Beringusz/Thrust_Vector_System/Thrust Vector Model/images/tvc_photo2.jpg

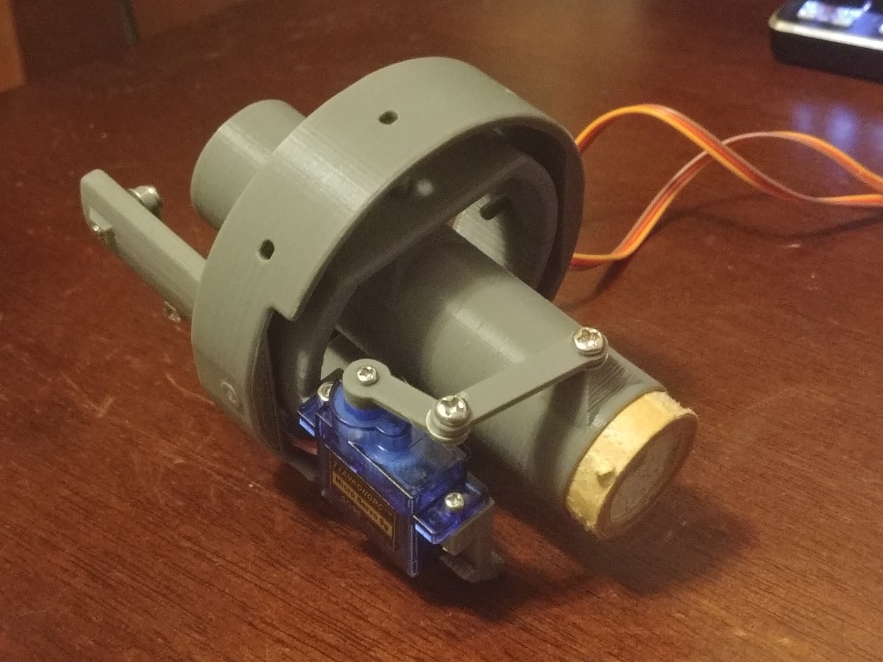
Thrust Vector Model/images/tvc_photo2.jpg
