Beringusz/Thrust_Vector_System/Thrust Vector Model/images/tvc_1.PNG

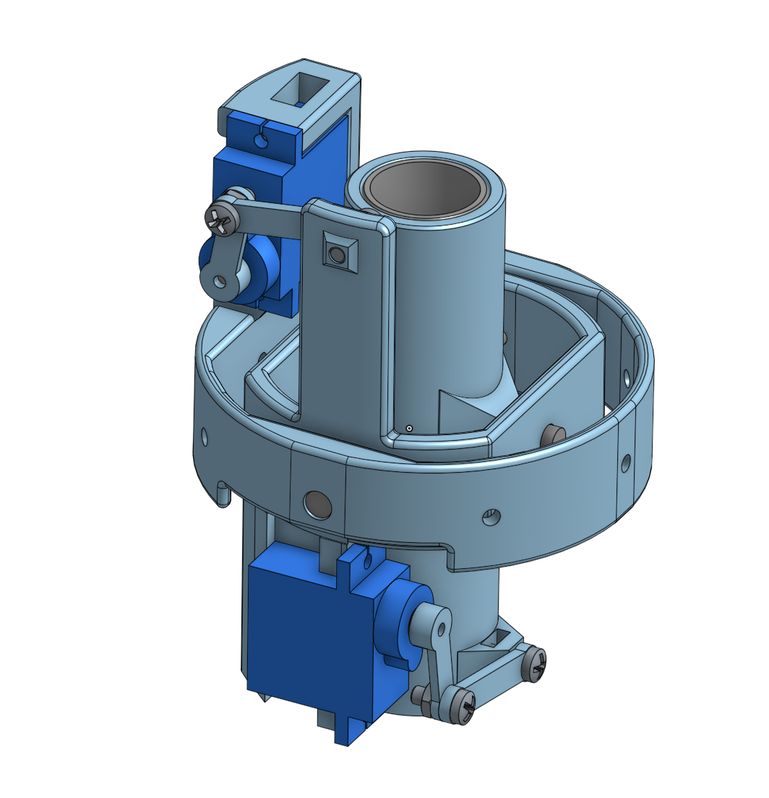
Thrust Vector Model/images/tvc_1.PNG
