Beringusz/Thrust_Vector_System/Thrust Vector Model/images/tvc_2.PNG

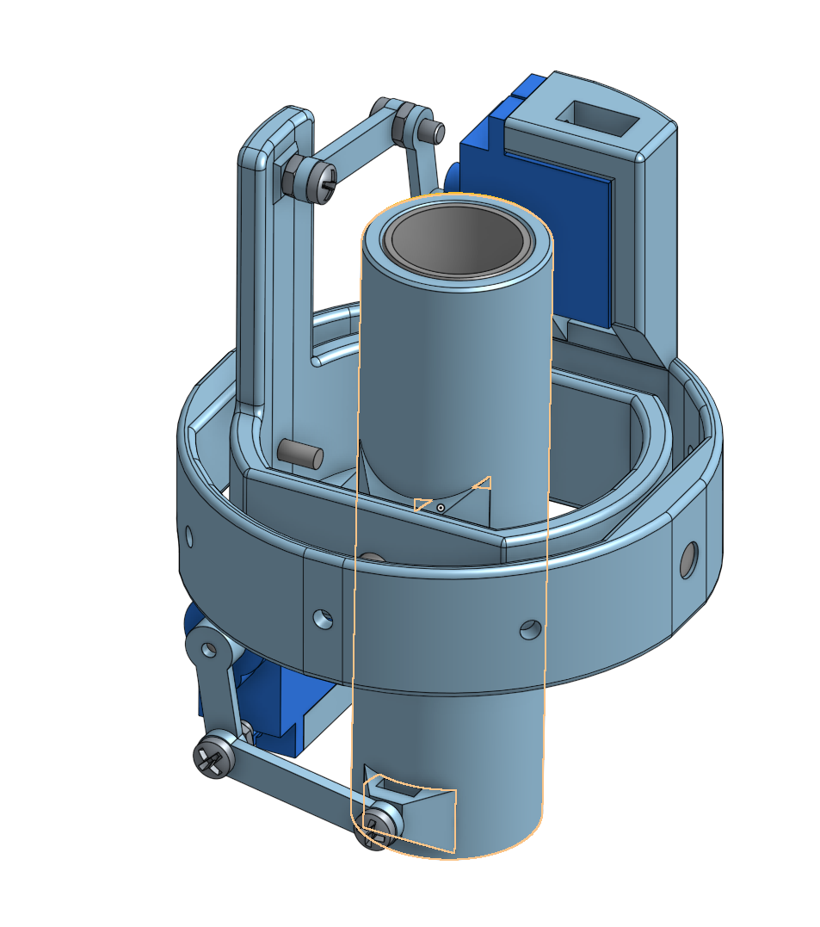
Thrust Vector Model/images/tvc_2.PNG
