Beringusz/Thrust_Vector_System/Thrust Vector Model/images/tvc_3.PNG

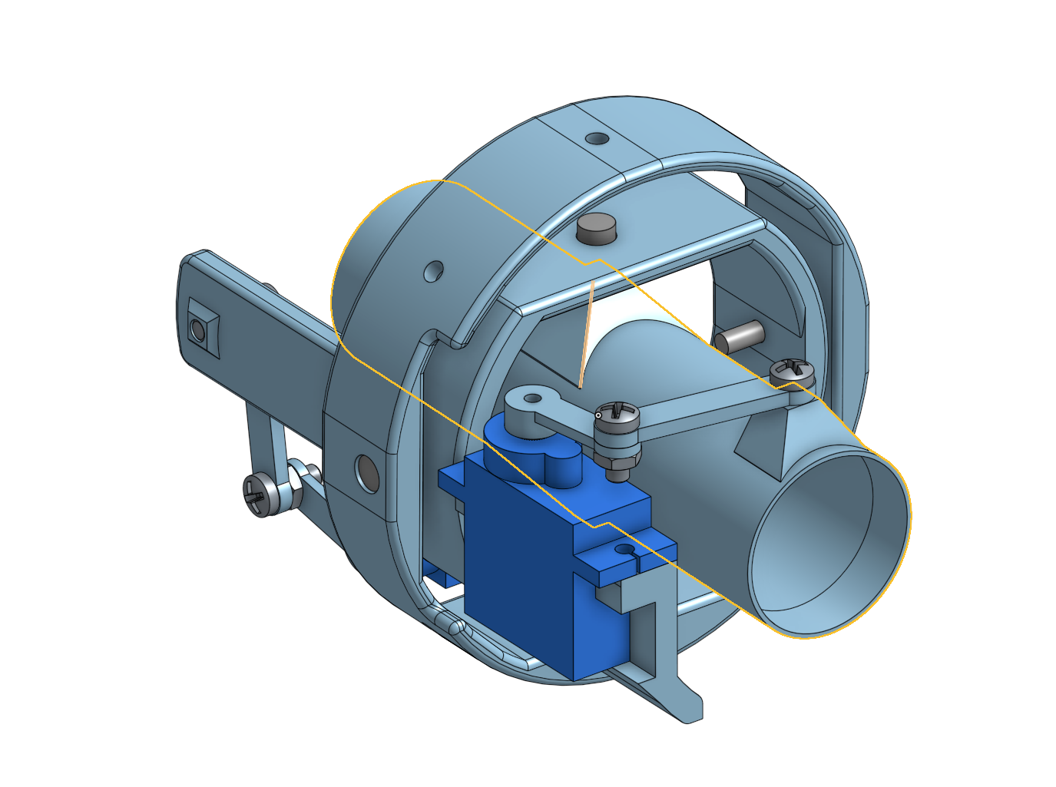
Thrust Vector Model/images/tvc_3.PNG
