Beringusz/Thrust_Vector_System/Thrust Vector Model/files/95mm_Buffer.stl

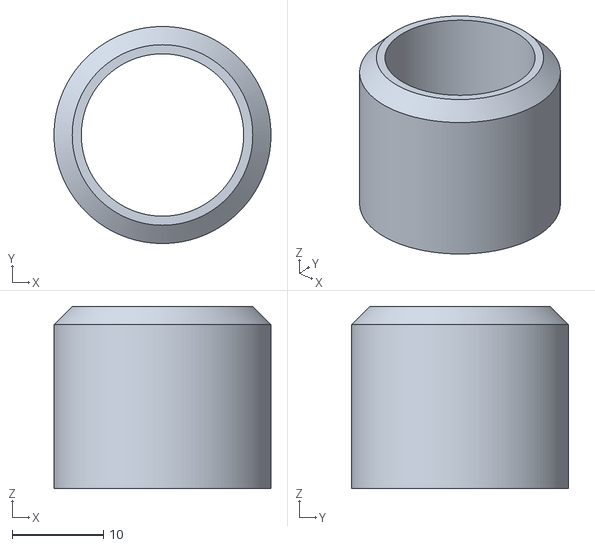
[picture p14: CAD file, 2026-10-13]
Thrust Vector Model/files/95mm_Buffer.stl
23.8 x 23.8 x 20.0
