Beringusz/Thrust_Vector_System/Thrust Vector Model/files/ServoHorn_15mm.stl

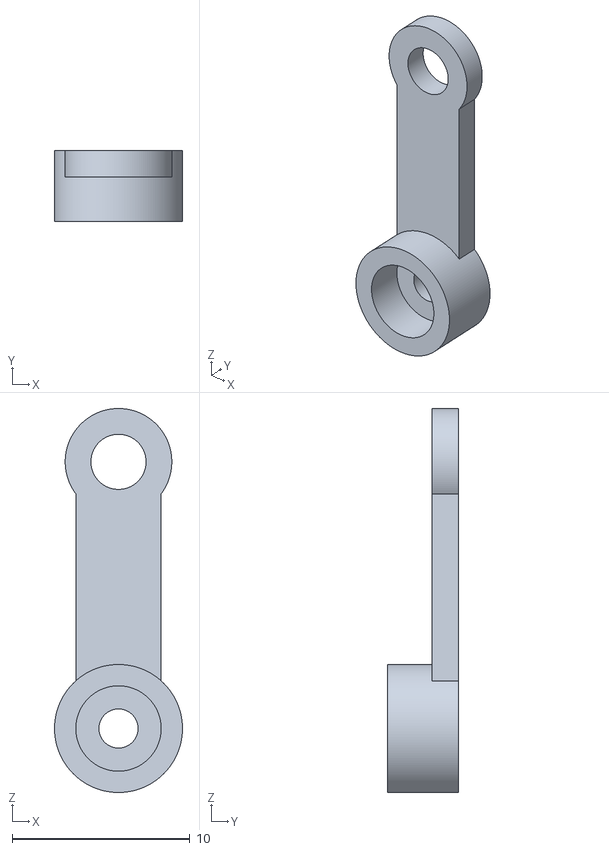
[picture p15: CAD file, 2026-10-13]
Thrust Vector Model/files/ServoHorn_15mm.stl
7.20 x 4.00 x 21.6
