Beringusz/Thrust_Vector_System/Thrust Vector Model/files/MotorShroud_24x75.stl

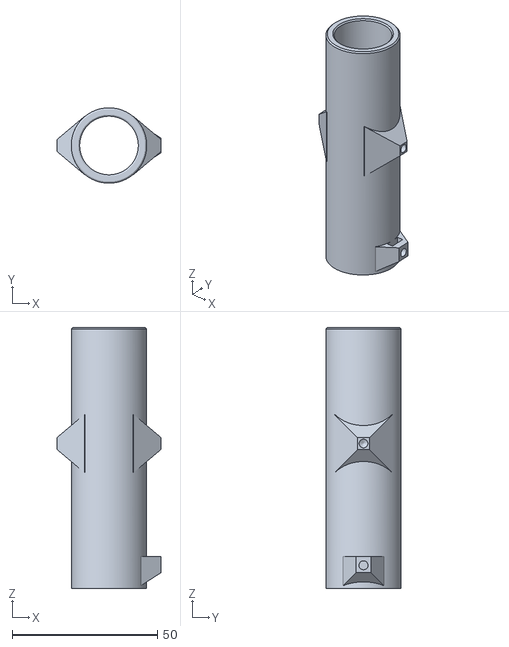
[picture p16: CAD file, 2026-10-13]
Thrust Vector Model/files/MotorShroud_24x75.stl
36.0 x 26.0 x 90.0
