Beringusz/Thrust_Vector_System/Thrust Vector Model/files/YAxisPin.stl

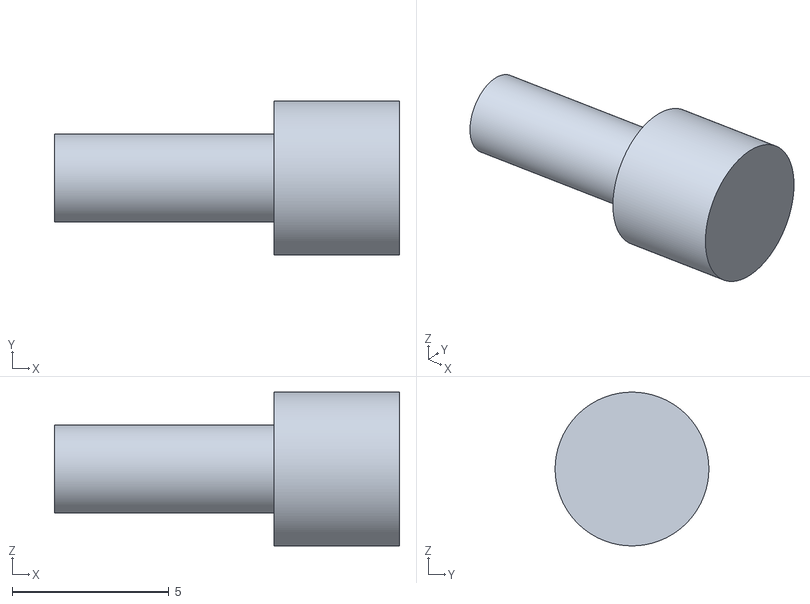
[picture p17: CAD file, 2026-10-13]
Thrust Vector Model/files/YAxisPin.stl
11.0 x 4.90 x 4.90
