Beringusz/Thrust_Vector_System/Thrust Vector Model/files/XAxisPin.stl

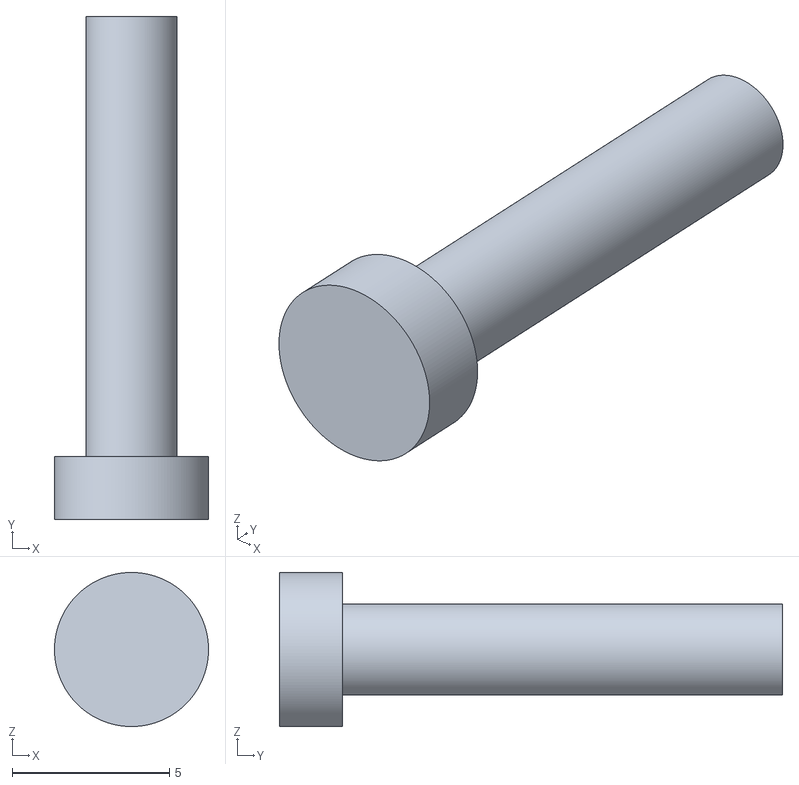
[picture p18: CAD file, 2026-10-13]
Thrust Vector Model/files/XAxisPin.stl
4.90 x 16.0 x 4.90
