Beringusz/Thrust_Vector_System/Thrust Vector Model/files/OuterGimbal.stl

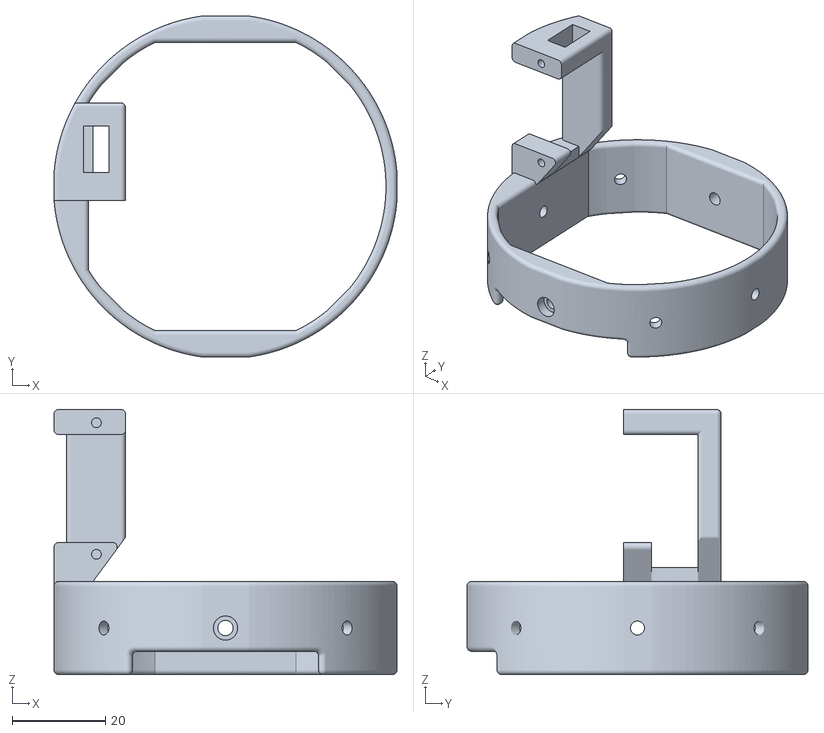
[picture p19: CAD file, 2026-10-13]
Thrust Vector Model/files/OuterGimbal.stl
73.8 x 73.3 x 57.0
