Beringusz/Thrust_Vector_System/Thrust Vector Model/files/ConnectorBar_25mm.stl

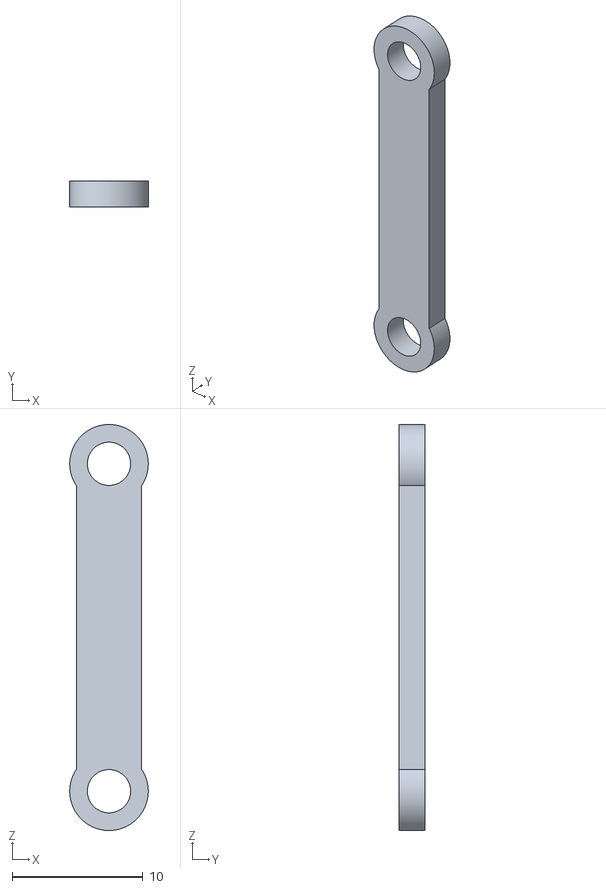
[picture p20: CAD file, 2026-10-13]
Thrust Vector Model/files/ConnectorBar_25mm.stl
6.00 x 2.00 x 31.0
