Beringusz/Thrust_Vector_System/Thrust Vector Model/files/InnerGimbal.stl

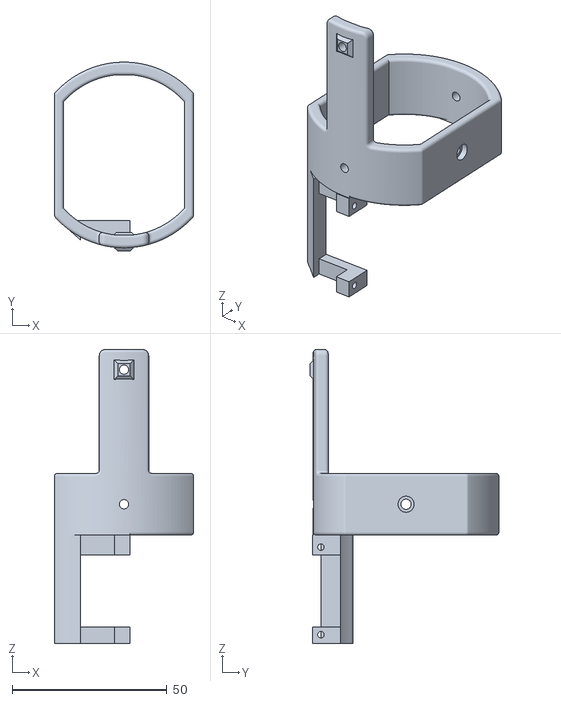
[picture p21: CAD file, 2026-10-13]
Thrust Vector Model/files/InnerGimbal.stl
45.0 x 61.0 x 95.0
