Beringusz/Thrust_Vector_System/(list of files, cad)

Other CAD files:
Thrust Vector Model/files/MotorShroud_24x95.stl
