Beringusz/Thrust_Vector_System/(commit log)

2026-10-13 Updated main with the arduino code file and project pdf file
2026-10-13 Uploaded the 3d models for the TVC system
    [95mm_Buffer.stl, ConnectorBar_25mm.stl, InnerGimbal.stl, MotorShroud_24x75.stl, MotorShroud_24x95.stl, OuterGimbal.stl, ServoHorn_15mm.stl, XAxisPin.stl]
2026-10-13 Revise README for Dual-Axis TVC Prototype
    Updated project title and expanded README content to provide detailed information about the dual-axis Thrust Vector Control prototype, including features, hardware mapping, and control law.
